krishivjoshi219-collab/Ohara-75/BOM.csv

Item | Qty | Supplier | Cost/item | Total Cost | link
7.5 inch Raw E-Paper Display (800x480 24-pin FPC GDEY075T7 UC8179 4-grayscale) | 1 | Alibaba (Good Display) | $40.26 | $40.26 | https://www.alibaba.com/product-detail/GooDisplay-GDEY075T7-7-5-4-Grayscale_1601841777300.html
ESP32-S3-WROOM-1-N8R8 Module (8MB Flash 8MB PSRAM) | 1 | Robu.in | $4.31 | $4.31 | https://robu.in/product/espressif-esp32-s3-wroom-1-n8r8-modules/
TC4056 1A Li-Ion Battery Charger IC (SOP-8 drop-in for TP4056) | 1 | Robu.in | $0.11 | $0.11 | https://robu.in/product/tc4056-fumen-electronics-co-ltd-1a-standalone-linear-li-ion-battery-charger-ic-8-soic/
MIC5219-3.3 500mA 3.3V LDO Voltage Regulator (SOT-23-5 drop-in for AP2112K) | 1 | Robu.in | $0.33 | $0.33 | https://robu.in/product/mic5219-3-3ym5-ms-msksemi-fixed-3-3v-24v-sot-23-5-voltage-regulators-linear-low-drop-out-ldo-regulators-rohs/
AFC04-S24FCA-00 24-Pin 0.5mm FPC Connector (EPD socket for J1) | 1 | Robu.in | $0.13 | $0.13 | https://robu.in/product/afc04-s24fca-00-jushuo-24p-bottom-contact-horizontal-attachment-0-5mm-smdp0-5mmsurface-mountright-angle-ffc-fpc-flat-flexible-connecto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
AO3400A N-Channel MOSFET SOT-23 (EPD boost switch Q1) | 1 | Robu.in | $0.03 | $0.03 | https://robu.in/product/ao3400-hxy-mosfet-30v-5-8a-30m%cf%8910v5-8a-1-4w-700mv-1-n-channel-sot-23-mosfets-rohs/
1N5819W Schottky Diode SOD-123 (EPD boost diode D1) | 1 | Robu.in | $0.02 | $0.02 | https://robu.in/product/1n5819w-kexin-40v-600mv1a-1a-sod-123-schottky-diodes-rohs/
TDK 10uH 1210 SMD Inductor (EPD boost inductor L1) | 1 | Robu.in | $1.25 | $1.25 | https://robu.in/product/tfm322512alma100mtaa-tdk-1-2a-10uh-%c2%b120-1-6a-305m%cf%89-1210-inductors-smd-rohs/
B2B-PH-K-S JST-PH 2-Pin 2mm Battery Connector (J4) | 1 | Robu.in | $0.09 | $0.09 | https://robu.in/product/b2b-ph-k-slfsn-jst-1x2p-2p-ph-tin-2-25%e2%84%8385%e2%84%83-2a-1-2mm-brass-straight-pluginp2mm-wire-to-board-connector-rohs/
1x40 Pin 2.54mm Male Berg Header Strip (J5 NAV header) | 1 | Robu.in | $0.08 | $0.08 | https://robu.in/product/1x40-berg-strip-male-connector/
TYPE-C-31-M-40 HRO 16-Pin USB-C SMD Receptacle (J3) | 1 | Robu.in | $0.47 | $0.47 | https://robu.in/product/type-c-31-m-40-hroparts-5a-1-16p-female-30%e2%84%8380%e2%84%83-type-c-smd-usb-connectors-rohs/
MSK12C02 SPDT SMD Slide Switch (Power switch SW10) | 1 | Robu.in | $0.08 | $0.08 | https://robu.in/product/msk12c02-shou-han-horizontal-attachment-50ma-single-pole-double-throw-spdt-12v-10000-times-smd-slide-switches-rohs/
3x6x2.5mm SMD Tactile Switch (SW3 Reset + SW4 Boot) 20pcs | 1 | Robu.in | $0.03 | $0.03 | https://robu.in/product/362-5mm-tactile-push-button-switch-20pcs/
10k Ohm 0805 SMD Resistor (R1 R3 R4 R5 pullups) x4 | 4 | Robu.in | $0.01 | $0.04 | https://robu.in/product/ac0805fr-7w10kl-yageo-250mw-thick-film-resistors-%c2%b1100ppm-%e2%84%83-%c2%b11-10k%cf%89-0805-chip-resistor-surface-mount-rohs/
5.1k Ohm 0805 SMD Resistor (R6 R7 CC pulldown) x2 | 2 | Robu.in | $0.005 | $0.01 | https://robu.in/product/rc0805fr-075k1l-yageo-res-thick-film-0805-5-1k-ohm-1-0-125w1-8w-%c2%b1100ppm-c-pad-smd-t-r/
1.2k Ohm 0805 SMD Resistor (R8 TP4056 PROG charger current) | 1 | Robu.in | $0.01 | $0.01 | https://robu.in/product/ac0805fr-071k2l-yageo-res-thick-film-0805-1-2k-ohm-1-0-125w1-8w-%c2%b1100ppm-c-pad-smd-t-r-automotive-aec-q200/
1 Ohm 0805 SMD Resistor RK73H2ATTD1R00F (R2 EPD boost current sense) | 1 | Robu.in | $0.01 | $0.01 | https://robu.in/product/rk73h2attd1r00f-koa-smd-chip-resistor1-ohm%c2%b1-1250-mw0805-2012-metricthick-filmprecision/
1k Ohm 0805 SMD Resistor Pack of 10 (R9 R10 LED current limiters) | 1 | Robu.in | $0.05 | $0.05 | https://robu.in/product/1k-ohm-1-4w-0805-surface-mount-chip-resistor-pack-of-10/
1uF 50V 0805 SMD MLCC Capacitor Pack of 10 (C1 C5 C10) | 1 | Robu.in | $0.01 | $0.01 | https://robu.in/product/1uf-1000nf-50v-capacitor-0805-smd-package-pack-of-10/
4.7uF 50V 0805 SMD MLCC Capacitor Pack of 5 x2 packs (C2 C3 C4 C6 C7 C8) | 2 | Robu.in | $0.035 | $0.07 | https://robu.in/product/4-7uf-4700nf-50v-capacitor-0805-smd-package-pack-of-5/
10uF 50V 0805 SMD MLCC Capacitor (C9 C11 C12) x3 | 3 | Robu.in | $0.048 | $0.14 | https://robu.in/product/0805x106k500nt-fh-50v-10uf-x5r%c2%b110-0805-multilayer-ceramic-capacitors-mlcc-smd-smt-rohs/
0805 LED Red SMD (D3 Charging indicator) | 1 | Robu.in | $0.01 | $0.01 | https://robu.in/product/0805-surface-mount-led-red-50-pcs/
0805 LED Green SMD (D2 Done indicator) | 1 | Robu.in | $0.01 | $0.01 | https://robu.in/product/0805-surface-mount-led-green-50-pcs/
3.7V 500mAh HCY-602030 LiPo Battery with JST-PH Connector | 1 | Amazon.in | $1.04 | $1.04 | https://www.amazon.in/Electronic-HCY-602030-Rechargeable-Connector-Electronics/dp/B0HC6RRYJL/
EVA Double-Sided Foam Battery Mounting Tape 50mm x 5m | 1 | Robu.in | $1.13 | $1.13 | https://robu.in/product/eva-foam-tape-50mm-5-mtr/
EasyMech M2.5x8mm Hex CSK Screw Set 10pcs (Case Assembly) | 1 | Robu.in | $0.83 | $0.83 | https://robu.in/product/easymech-m25-x-8mm-hex-allen-csk-high-tensile109-black-oxide-screw-dia-25mm-length-8mm/
Robu.in Domestic Shipping | 1 | Robu.in | $0.52 | $0.52 | https://robu.in/
Custom Ohara-75 2-Layer PCB Fabrication (5 pcs) | 1 | JLCPCB | $9.00 | $9.00 | https://www.jlcpcb.com/
Print Legion 3D Enclosure (Base Tray + Lid) | 1 | Hack Club Print Legion | $9.00 | $9.00 | https://hackclub.com/printlegion/
Total |  |  |  |  | $69.07
