krishivjoshi219-collab/Ohara-75/3d/Ohara-75-Lid.stl

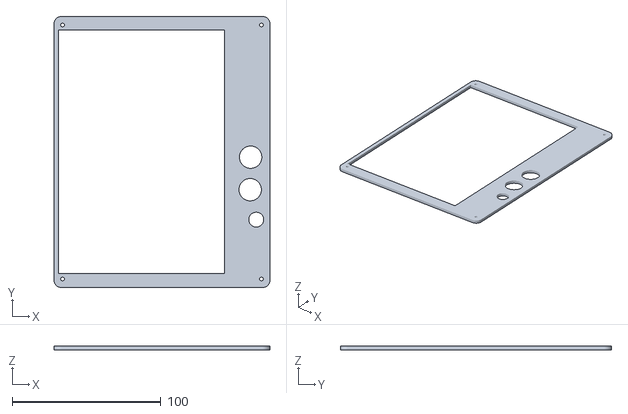
[picture p3: CAD file, 2026-11-01]
3d/Ohara-75-Lid.stl
145.0 x 182.0 x 2.50
