krishivjoshi219-collab/Ohara-75/Ohara-75.step

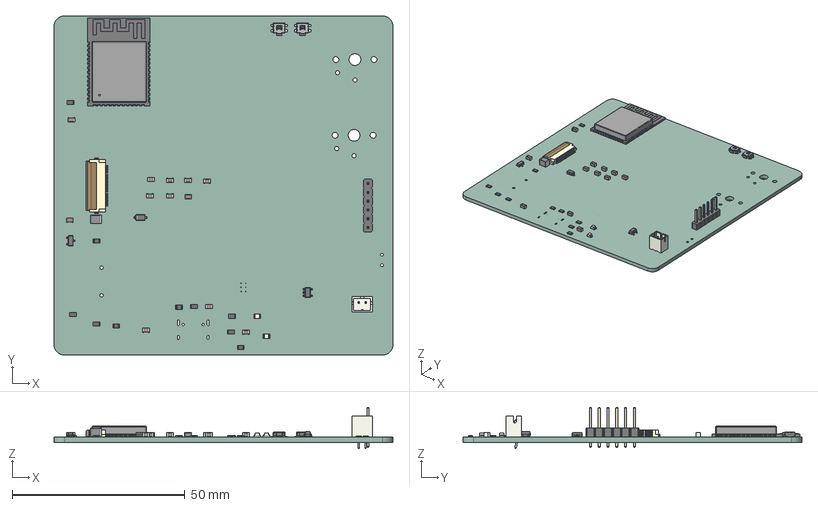
[picture p4: CAD file, 2026-11-01]
Ohara-75.step
98.0 x 98.0 x 11.9 mm
C_0805_2012Metric x 12
D_SOD-123
ESP32-S3-WROOM-1
PinHeader_1x06_P254mm_Vertical
SW_SPST_EVQP7A x 2
LED_0805_2012Metric x 2
R_0805_2012Metric x 10
L_1210_3225Metric
JST_B2B_PH_K
SOT-23
SOT-23-5
Hirose_FH12_xxS_0_5SH_Parametric_v0_1
lock
pins
Ohara-75-unsaved-export-RvjyiI_PCB
