krishivjoshi219-collab/Ohara-75/3d/Ohara-75-Base-Tray.stl

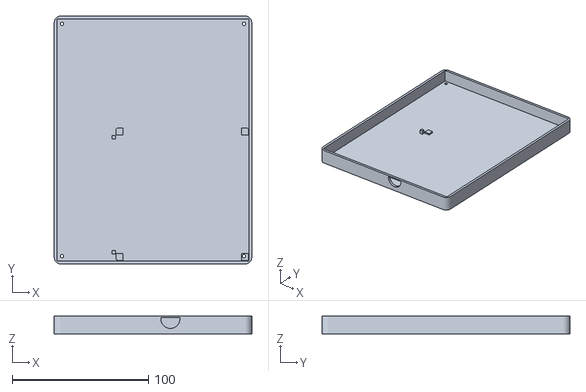
[picture p5: CAD file, 2026-11-01]
3d/Ohara-75-Base-Tray.stl
145.0 x 182.0 x 13.0
