krishivjoshi219-collab/Ohara-75/JOURNAL.md

# Ohara-75: devlog

<!-- Generated by Half Life from project lvta3gn5t2jh8xfjrf30q02m. Edits here are overwritten on the next sync. -->
<!-- Generated: 2026-11-01T15:03:44.939Z -->

> [!NOTE]
> This devlog is mirrored from [Half Life](https://halflife.hackclub.com) ([open the project](https://halflife.hackclub.com/projects/lvta3gn5t2jh8xfjrf30q02m)). Editing it here will not change the platform's copy, and the next sync overwrites this file.

> A e-ink-reader !!!!!!!!!!!!!!! with one piece features !!!!!!!!!! powered by esp32 and a e-paper screen for reading manga or novels with 0 eye strain

| Week | Tier | Hours logged | Entries |
| --- | --- | --- | --- |
| Week 4 | Tier 2 | 20h | 3 |

## Contents

1. [2026-10-30: Hi!!!! hc reviwer](#2026-10-30-hi-hc-reviwer)
2. [2026-10-31: Hi HC reviewer's](#2026-10-31-hi-hc-reviewers)
3. [2026-11-01: Hi Hack club reviewers this is the finial AND FINIAL journal !!!!! here i will attach the screenshots of the 3D modeling and the onshape link so you can like uh see the livee time stamp here](#2026-11-01-hi-hack-club-reviewers-this-is-the-finial-and-fin)

## Design

### 2026-10-30: Hi!!!! hc reviwer

**9h**

Hi!!!! hc reviwer
yo this is my first week 4 entrey i didn't want to do small entries so i didn;t log the 2.5 hrs of reasearch (in hallf-life i was told that research and finilizing the idea in a custom project counts as real work)
1. Research
So i was bically finilizing what to build i had  a idea of the e-ink-reader but i had no idea how to build it !!!!!!!!!!!!
so then i researched aobut what to build and finilized the esp32-S3 and my MAIN MOVITE IS TO READ MANGA ON IT !!!!!! I HAVE LIKE 2 KATHLIC SWITCHES FOR THE PAGE BACK AND FORWARDS TOO !!!! in the sch. !!!!!!!!! then i also finilized a battery and a name and how will i construct a 3D modle like what it will have etc and  a microSD card of 32GB so i can read offilne this isn't just SOME project for me it's something i am planning to use for my entire school years !!!!!!!!!!!!!!!! but yeah like you can't use the staribe or maerbl run everyday !!!!!!!!!!! but my week 3 project tone dial was a blast too !!!! anyways here is the sch. here are allt here are all the screenshots of my work so my 9 hours are backed my screenshots of some 7.5 hours ig ???? + that2.5 hours in the research

2 Schemtic
starting with a blank screen !!!!!!

Screenshot from 2026-10-29 18-09-59
got the microcontroller !!!!
Screenshot from 2026-10-29 18-23-20

Screenshot from 2026-10-29 18-46-27

Screenshot from 2026-10-29 18-53-09

Screenshot from 2026-10-29 19-19-08
started on the e-paper displays !!!!
Screenshot from 2026-10-29 19-32-13

Screenshot from 2026-10-29 20-57-23
here i started adding leadels it was a mess really !!!! :sob: it was a hellish day
Screenshot from 2026-10-29 21-07-03

Screenshot from 2026-10-29 21-16-01
here i stated adding capacitors to the display since i am buying  a raw e-paper without the devkit (to save hack club moeny as writen in the rules that not to waste hc money )
Screenshot from 2026-10-29 21-39-03

Screenshot from 2026-10-30 14-48-13

Screenshot from 2026-10-30 15-00-16

Screenshot from 2026-10-30 15-17-56

Screenshot from 2026-10-30 15-42-27
here i steaded the SD card if it's the right creenschot i was typing under ig uh system names for the screenshot are too much trash

Screenshot from 2026-10-30 15-46-52

Screenshot from 2026-10-30 15-59-55

Screenshot from 2026-10-30 16-09-53

Screenshot from 2026-10-30 16-17-18

Screenshot from 2026-10-30 16-22-36

Screenshot from 2026-10-30 16-29-21

Screenshot from 2026-10-30 16-39-08

Screenshot from 2026-10-30 16-48-03

Screenshot from 2026-10-30 17-11-13

Screenshot from 2026-10-30 18-10-17

Screenshot from 2026-10-30 18-14-29

Screenshot from 2026-10-30 18-49-25

Screenshot from 2026-10-30 18-51-51
and this are the buttons if i am typing under the right schrrenshots
Screenshot from 2026-10-30 18-53-09

Screenshot from 2026-10-30 19-00-24

Screenshot from 2026-10-30 19-11-03

Screenshot from 2026-10-30 19-19-28
this WAS MY 5 WAY BUTTONS UNTILL I REPLACED IT WITH A 6 PIN HEADER
Screenshot from 2026-10-30 20-01-47
finial sch. !!!

Finial footprints !!!!
i deducted hours for dinner breakes etc
of ~1h 25mins and some ~40-50mins
And also this is my 3RD TIME DESIGNED A PCB 1!!!!!!! but it's really hard to manage

### 2026-10-31: Hi HC reviewer's

**4h**

Hi HC reviewer's
Today wa sa good day cuz i did something i really liked the PCB routing and placemtn !!!!!!!!!!!!!!
so this what is looked like when i updated the pcb form the shcemetic
Screenshot from 2026-10-31 12-12-47

Screenshot from 2026-10-31 12-25-18
Then i wanted a custom edge.cuts like a straw hats like i did in the week 1 starbie or like in the week 3 project !!!!!! but then i realized that i am doing  a e-ink-reader so it needs a recatnalge PCB !!!!!!!!!
and as you can see here i tried with the pcb of 140*175
Screenshot from 2026-10-31 12-28-31

but eneded up with the 98*98 since JLCPCB is cheap only untill the 100*100 limit !!!!!
Screenshot from 2026-10-31 13-22-27

Screenshot from 2026-10-31 13-39-09

Screenshot from 2026-10-31 13-41-34
then i started of like here eneded the placemnt since placement is the key to the routing !!!!!!! :D!!!!!!!!!!! PLACEMNT WAS EASY so nothing went wrong just some fixes like had the USB C port inside first of all since i am a beginner i used to think the placemnt is hard but then i relaized that it's nothing wrong !!!!!! it just look at the schementic think a little and placemnt the compoents which connect together near so i was easy just some thinking was needed !!!!!! :D but i really had a HELL WITH THE R AND C since all of there names are just R1,2,3...... and C1,2,3....... so i placed all like i never thought so i had to correct piece of cake !!!!!!!!!!!!!!!!!!

Screenshot from 2026-10-31 13-45-10
here i moved the USB C to it right position and mosed the other R etc up so i can plag in a USB C !!!!
Screenshot from 2026-10-31 13-49-21

Screenshot from 2026-10-31 13-51-38

Screenshot from 2026-10-31 13-54-33

Screenshot from 2026-10-31 13-56-43
here i rotated the power switch i didn't know that i had placed it in the wrong direction untill i did a finial check of the placemtn then i started the routing
Screenshot from 2026-10-31 14-00-56
GND net then the classic rotuing i don't think i need to explain WHAT WENT WRONG IN THE ROUTING SINCE ALL KNOW WHAT WENTS WRONG IN THE ROUTING I HAD A PDB DEADLOCK :c :C !!!!!!!!!!!!!!
Screenshot from 2026-10-31 14-03-02

Screenshot from 2026-10-31 14-05-20

Screenshot from 2026-10-31 14-16-55

Screenshot from 2026-10-31 14-22-52

Screenshot from 2026-10-31 14-41-54

Screenshot from 2026-10-31 15-00-34

Screenshot from 2026-10-31 15-08-06

Screenshot from 2026-10-31 15-12-29

Screenshot from 2026-10-31 15-36-36

Screenshot from 2026-10-31 16-33-32
so like this is what the finial pcb BEFORE SILKSCREEN looks like i changed the GND fill from thermal to soild connection and also changed the min hold drill to like uh yeah 0.2 mm nothing more it was fun and took some 4h and 20 mins some 3.5-6 h for routing and placemnt setc andother for think how to proceedin the deadllock and fix the DRC errors
and also in the entire hour in which there i no screenshots i was fixing the DRC erorrs i must have attacted it's screenshot before i was like HELL 50 ERRORS and then uh there were all thermal relief and that drill hole min erorr !!! but took a long time to fingue out but mot time was taked by the deadlock !!!!! :C
i rouned it up to 4 so it gives CLEAN number no messy 20min
Thx for reading

### 2026-11-01: Hi Hack club reviewers this is the finial AND FINIAL journal !!!!! here i will attach the screenshots of the 3D modeling and the onshape link so you can like uh see the livee time stamp here

**7h**

Hi Hack club reviewers this is the finial AND FINIAL journal !!!!! here i will attach the screenshots of the 3D modeling and the onshape link so you can like uh see the livee time stamp here
https://cad.onshape.com/documents/ea0aa5899e68c988299c6c01/w/444ee3a1f6598db6ea51fffb/e/8477d663f29412e1f5501389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
and this are the screenshots

Screenshot from 2026-11-01 00-52-02

Screenshot from 2026-11-01 01-27-14

Screenshot from 2026-11-01 01-28-44

Screenshot from 2026-11-01 01-34-03

Screenshot from 2026-11-01 01-41-57

Screenshot from 2026-11-01 01-44-39

Screenshot from 2026-11-01 01-48-40

Screenshot from 2026-11-01 01-49-24

Screenshot from 2026-11-01 01-53-14

Screenshot from 2026-11-01 01-54-46

Screenshot from 2026-11-01 01-58-29

Screenshot from 2026-11-01 02-03-20

Screenshot from 2026-11-01 02-08-37

Screenshot from 2026-11-01 02-17-03

Screenshot from 2026-11-01 02-19-09

Screenshot from 2026-11-01 02-25-41

Screenshot from 2026-11-01 02-30-28

Screenshot from 2026-11-01 13-29-58

Screenshot from 2026-11-01 14-10-43

Screenshot from 2026-11-01 14-14-15

Screenshot from 2026-11-01 14-35-49

Screenshot from 2026-11-01 14-46-27

Screenshot from 2026-11-01 14-48-43

Screenshot from 2026-11-01 14-58-08

Screenshot from 2026-11-01 15-00-39

Screenshot from 2026-11-01 15-15-41

Screenshot from 2026-11-01 15-18-08

Screenshot from 2026-11-01 15-21-12

Screenshot from 2026-11-01 15-25-32

Screenshot from 2026-11-01 15-46-18

Screenshot from 2026-11-01 15-49-22

Screenshot from 2026-11-01 15-51-47

Screenshot from 2026-11-01 16-04-42

Screenshot from 2026-11-01 16-10-53

Screenshot from 2026-11-01 17-30-35
so basically this is what i ended up with and also thr thing which went the most wrong was the USB C :C !!!!!!!!!!!!!!!!!!!!!!!!!!!!!! then i just uh did it in the bambu stuio and then otherwise it was the most fun project i have EVER-EVER build and also uh since i am not that much proficient in the coding i just like started !!!!!!!!!!!!!!!!!!!!!!!!!!!!!!!!!!!!!!!!!!!!!!!!!!!!!!!!!!!!!!!!!!!!!!!!!!!!!!!!!!!!!!!!!!!!!! since i am 13 !!!!!!!!!!!!!!!!!!!!!!!!!!!!!!!!!!!!
and I JUST STARTERED !!!!!!!!!!!!!!!!!! so i used ai as the guide for the frimware but i typed it with my own hands just followed the ai's guide !!! :C sry but there was nothing i could do !!!!!!!!!!!!!!!!!!!!!!!! :C !!!!!!!!!!!!!!!!!!!!!!!!!!!!! :sob: !!!!!!!!!!!!!! and then i added a silk screeen here and the git commint and the readme etc and also uh i didn't include the time of the that uh frimware sicne i just typed it the locagic was ai's so i CANNOT LOG IT !!! WITHOUT AFFECTING MY SELF RESPECT SO LIKE YEAH I LIKEUH !!!!!!!!!!!!! WORK FOR ALL THE 5.5 H !!!!!!!!!!!!!!!!!!!!!!!!!!!!!!!!!!!!!!!!!!!!!!!!! AND NOW I WILL CREATED THE BOM !!!!!!!!!!!!!!!!!!!!!!!!!!!!!! :YAY: !!!!!!!!!!!!!!!!!!!!!!!!!!!!!!!!!!!!!!!!!!!!!!!!!!!!!!!!!!!!!!!!!!!!!!!!!!!!!!!!!!!!!!!!!!!!! AND ALSO UH SRY IF MY README FEELS TOO MUCH CHAOTIC K !!!!!!!!!!!!!!!!!!!!!!!!!!!!!!!!!!!!!!!!!!!!!!!!!!!!!!!!!!!!!!!!!!!!! WAIT I AM CHEATIC HERE TOO !!!!!!!!!!!!!!!!!!!!!!!!!!!!!!
AND YEAH SRY FOR MY SPELLING AS I SAID IN THE REAMDME TOO AND HELL WHY I AM I TYPING IN THE CPAS THE WHOLE TIME !!!!!!!!!!!!!!!!!!!!!!!!!!!!!!!!!!!!!!! !!!!!!!!!!!!!!!!!
thx for reading
all the proff for the 3d modeling and the silkscreen is in the onshape link and the that uh  my repo files thx for reading
and uh BOM is what is taking real time finding for the BOM is a trash
