krishivjoshi219-collab/Ohara-75/Ohara-75.kicad_pcb

## KiCad design Ohara-75.kicad_pcb (2026-11-01)

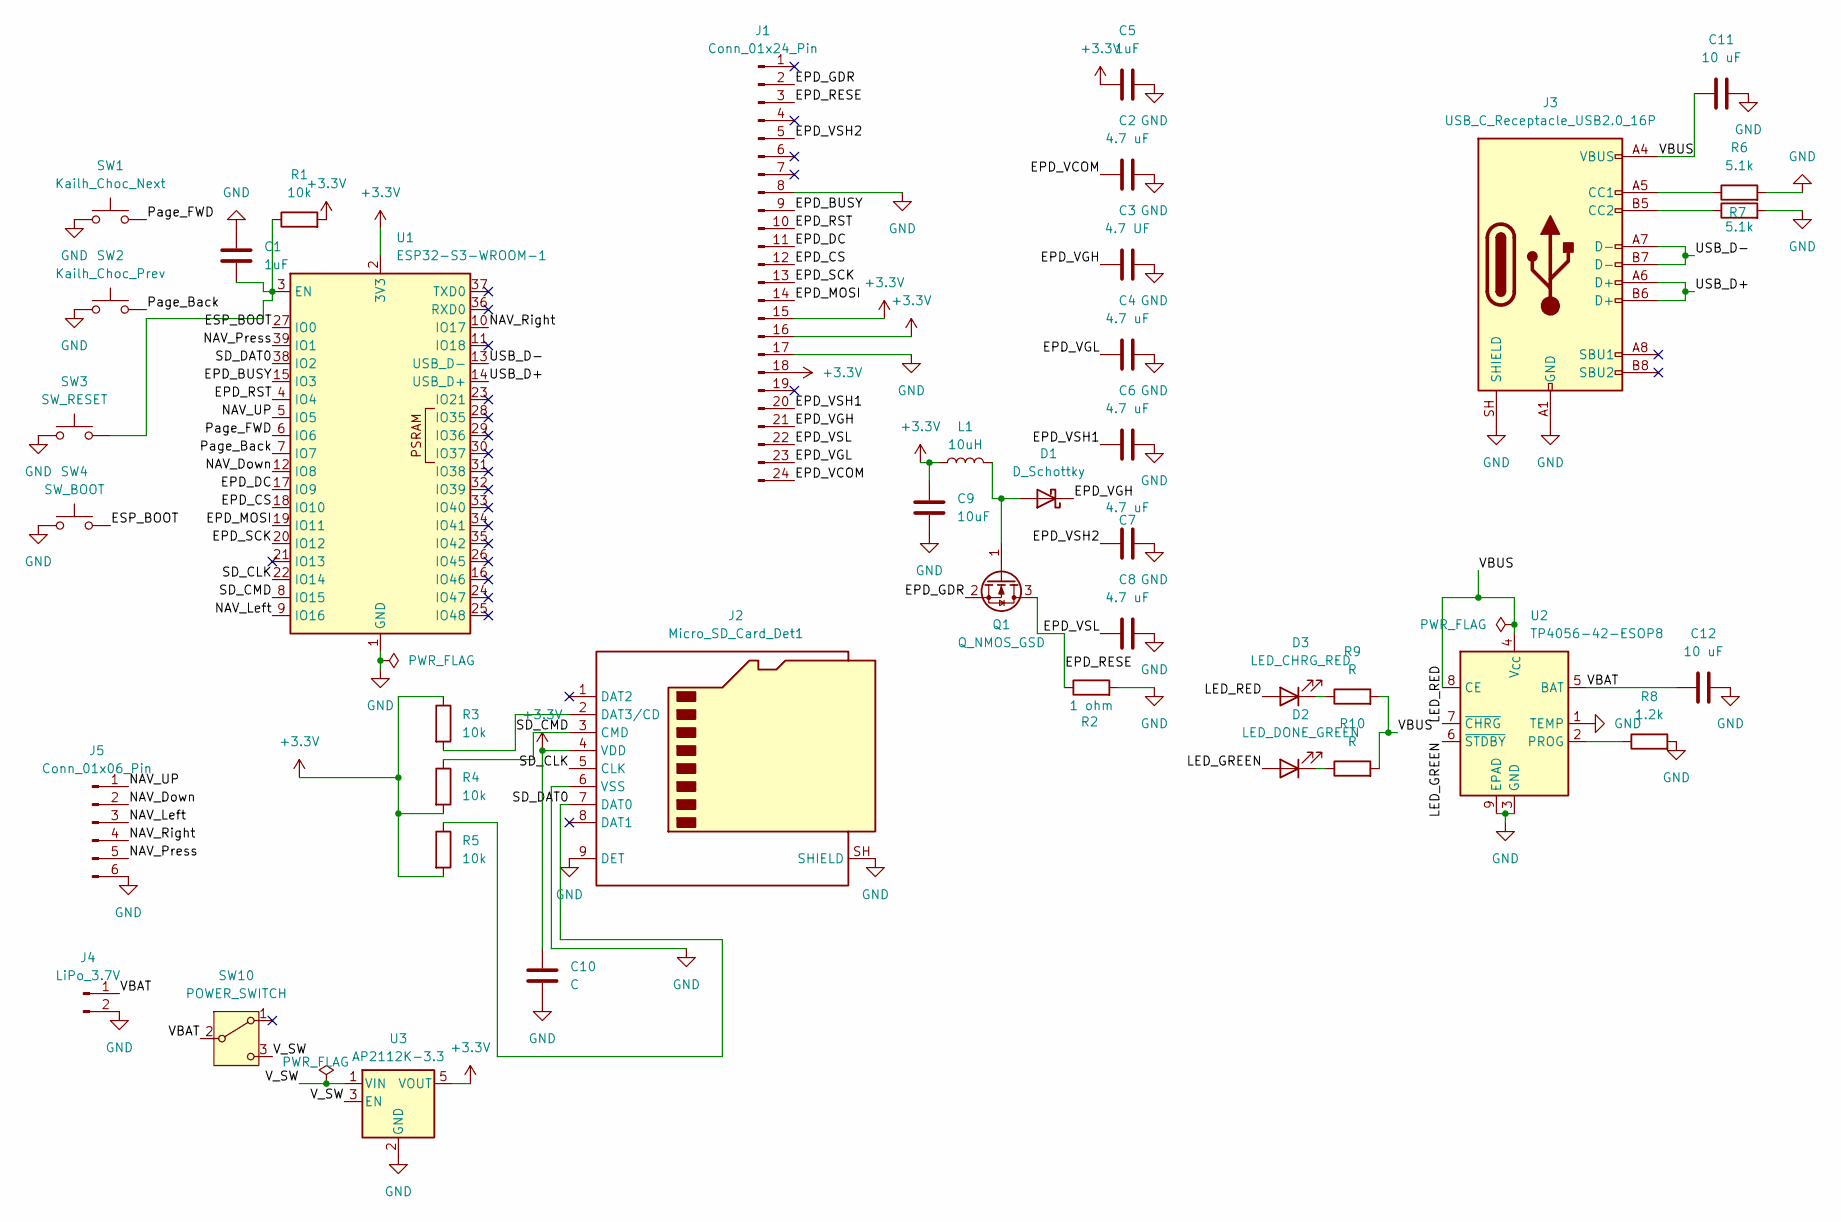
[picture p6: schematic Ohara-75.kicad_sch]

Parts:
C1, C5: 1uF; C_0805_2012Metric
C2, C4, C6, C7, C8: 4.7 uF; C_0805_2012Metric
C3: 4.7 UF; C_0805_2012Metric
C9: 10uF; C_0805_2012Metric
C10: C; C_0805_2012Metric
C11, C12: 10 uF; C_0805_2012Metric
D1: D_Schottky; D_SOD-123
D2: LED_DONE_GREEN; LED_0805_2012Metric
D3: LED_CHRG_RED; LED_0805_2012Metric
J1: Conn_01x24_Pin; Hirose_FH12-24S-0.5SH_1x24-1MP_P0.50mm_Horizontal
J2: Micro_SD_Card_Det1; microSD_XKB_XKTF-015-N
J3: USB_C_Receptacle_USB2.0_16P; USB_C_Receptacle_HRO_TYPE-C-31-M-12
J4: LiPo_3.7V; JST_PH_B2B-PH-K_1x02_P2.00mm_Vertical
J5: Conn_01x06_Pin; PinHeader_1x06_P2.54mm_Vertical
L1: 10uH; L_1210_3225Metric
Q1: Q_NMOS_GSD; SOT-23
R1, R3, R4, R5: 10k; R_0805_2012Metric
R2: 1 ohm; R_0805_2012Metric
R6, R7: 5.1k; R_0805_2012Metric
R8: 1.2k; R_0805_2012Metric
R9, R10: R; R_0805_2012Metric
SW1: Kailh_Choc_Next; SW_Kailh_Choc_v1
SW2: Kailh_Choc_Prev; SW_Kailh_Choc_v1
SW3: SW_RESET; SW_SPST_EVQP7A
SW4: SW_BOOT; SW_SPST_EVQP7A
SW10: POWER_SWITCH; SW_SPDT_Shouhan_MSK12C02
U1: ESP32-S3-WROOM-1
U2: TP4056-42-ESOP8; SOIC-8-1EP_3.9x4.9mm_P1.27mm_EP2.41x3.3mm_ThermalVias
U3: AP2112K-3.3; SOT-23-5

Connections:
+3.3V: C5.1, C9.1, C10.1, J1.15, J1.16, J1.18, J2.4 (VDD), L1.1, R1.2, R3.1, R4.2, R5.2, U1.2 (3V3), U3.5 (VOUT)
/EPD_BUSY: J1.9, U1.15 (IO3)
/EPD_CS: J1.12, U1.18 (IO10)
/EPD_DC: J1.11, U1.17 (IO9)
/EPD_GDR: J1.2, Q1.2 (S)
/EPD_MOSI: J1.14, U1.19 (IO11)
/EPD_RESE: J1.3, Q1.3 (D), R2.1
/EPD_RST: J1.10, U1.4 (IO4)
/EPD_SCK: J1.13, U1.20 (IO12)
/EPD_VCOM: C2.1, J1.24
/EPD_VGH: C3.1, D1.1 (K), J1.21
/EPD_VGL: C4.1, J1.23
/EPD_VSH1: C6.1, J1.20
/EPD_VSH2: C7.1, J1.5
/EPD_VSL: C8.1, J1.22
/ESP_BOOT: SW4.2, U1.27 (IO0)
/LED_GREEN: D2.2 (A), U2.6 (~STDBY)
/LED_RED: D3.2 (A), U2.7 (~CHRG)
/NAV_Down: J5.2, U1.12 (IO8)
/NAV_Left: J5.3, U1.9 (IO16)
/NAV_Press: J5.5, U1.39 (IO1)
/NAV_Right: J5.4, U1.10 (IO17)
/NAV_UP: J5.1, U1.5 (IO5)
/Page_Back: SW2.2, U1.7 (IO7)
/Page_FWD: SW1.2, U1.6 (IO6)
/SD_CLK: J2.5 (CLK), U1.22 (IO14)
/SD_CMD: J2.3 (CMD), R4.1, U1.8 (IO15)
/SD_DAT0: J2.7 (DAT0), R5.1, U1.38 (IO2)
/USB_D+: J3.A6 (D+), J3.B6 (D+), U1.14 (USB_D+)
/USB_D-: J3.A7 (D-), J3.B7 (D-), U1.13 (USB_D-)
/VBAT: C12.1, J4.1, SW10.2 (B), U2.5 (BAT)
/VBUS: C11.1, J3.A4 (VBUS), J3.A9 (VBUS), J3.B4 (VBUS), J3.B9 (VBUS), R9.2, R10.2, U2.4 (V_{CC}), U2.8 (CE)
/V_SW: SW10.3 (C), U3.1 (VIN), U3.3 (EN)
GND: C1.1, C2.2, C3.2, C4.2, C5.2, C6.2, C7.2, C8.2, C9.2, C10.2, C11.2, C12.2, J1.8, J1.17, J2.6 (VSS), J2.9 (DET), J2.SH (SHIELD), J3.A1 (GND), J3.A12 (GND), J3.B1 (GND), J3.B12 (GND), J3.SH (SHIELD), J4.2, J5.6, R2.2, R6.2, R7.2, R8.2, SW1.1, SW2.1, SW3.1, SW4.1, U1.1 (GND), U1.40 (GND), U1.41 (GND), U2.1 (TEMP), U2.3 (GND), U2.9 (EPAD), U3.2 (GND)
unnamed: D1.2 (A), L1.2, Q1.1 (G)
unnamed: D2.1 (K), R10.1
unnamed: D3.1 (K), R9.1
unnamed: J2.2 (DAT3/CD), R3.2
unnamed: J3.A5 (CC1), R6.1
unnamed: J3.B5 (CC2), R7.1
unnamed: C1.2, R1.1, SW3.2, U1.3 (EN)
unnamed: R8.1, U2.2 (PROG)

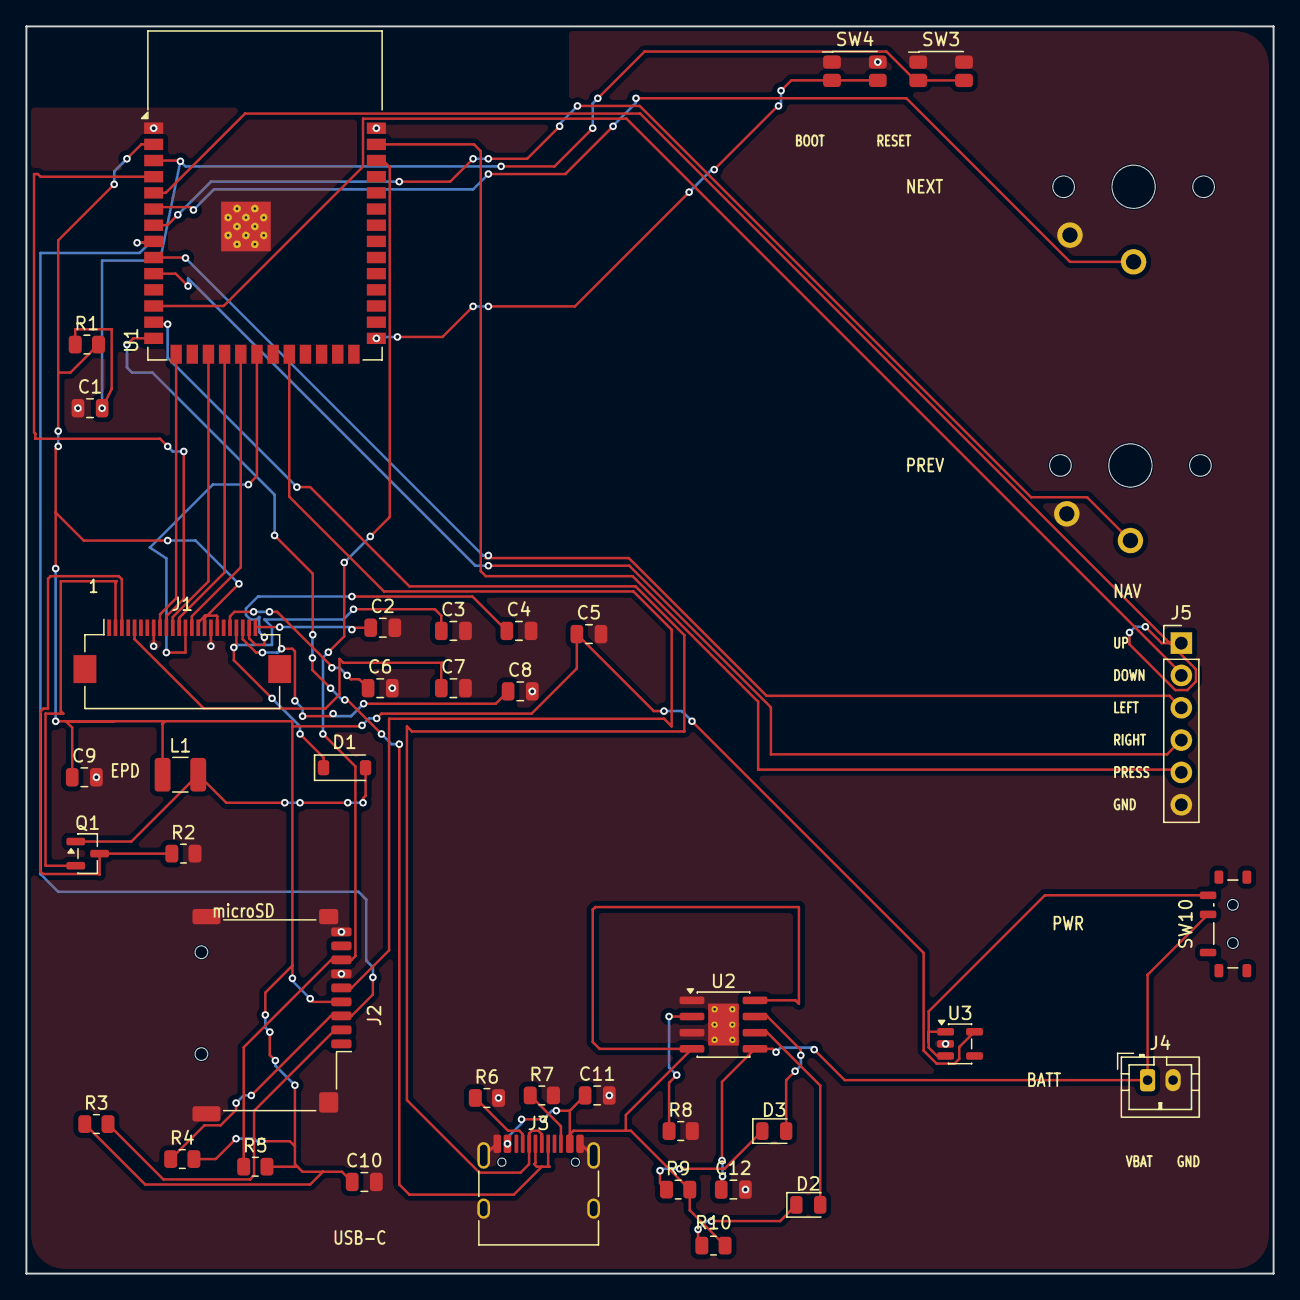
[picture p7: board Ohara-75.kicad_pcb from above]

Board: 2 copper layers, 98.0 x 98.0 mm, 40 parts (0 on the bottom side), 42 nets.
