krishivjoshi219-collab/Ohara-75/(commit log)

2026-11-01 Complete itemized BOM under 5 total budget (4.42 components + 3 PCB + 3D)
    [BOM.csv]
2026-11-01 Update BOM with in-stock ESP32-S3-WROOM-1-N8R8 and Good Display 7.5 raw panel under 5 limit
    [BOM.csv]
2026-11-01 Update BOM with 100% verified non-404 live URLs and verified slugs
    [BOM.csv]
2026-11-01 Sync exact cart items and in-stock battery and connectors
    [BOM.csv]
2026-11-01 Update BOM.csv with in-stock suppliers and verified budget totals
    [BOM.csv]
2026-11-01 Update BOM with headless-verified in-stock Robu items and exact 3 budget
    [BOM.csv]
2026-11-01 Add 32GB MicroSD, EVA battery tape, verified in-stock components (3.70 total)
    [BOM.csv]
2026-11-01 Update display to Good Display Factory OEM direct bare panel link (8.00)
    [BOM.csv]
2026-11-01 Sync Ohara-75 from Half Life
    [BOM.csv]
2026-11-02 Update BOM: complete verified 40/40 PCB components, live in-stock links, PCB=$9, 3D=$9
    [BOM.csv]
2026-11-02 Update BOM: finalize budget at 7.93 within Hack Club 8 margin (Option 1)
    [BOM.csv]
2026-11-02 Fix TC4056 Robu URL to active in-stock product page
    [BOM.csv]
2026-11-02 Update BOM with 100% verified direct in-stock product links (Cart=True)
    [BOM.csv]
